danecreekphotography/electronics/README.md

# electronics
Random electronics projects
