danecreekphotography/electronics/LED controller board - Wemos/3D Models/Molex 22-05-3041 4-pin male horizontal.step

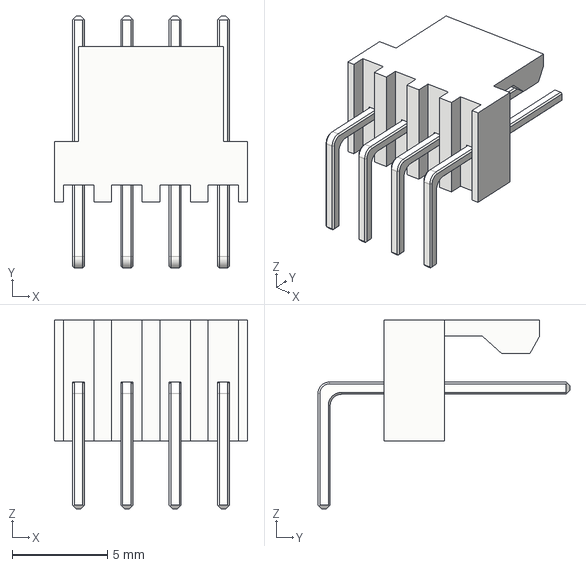
[picture p2: CAD file, 2020-07-19]
LED controller board - Wemos/3D Models/Molex 22-05-3041 4-pin male horizontal.step
10.2 x 13.2 x 9.93 mm
