danecreekphotography/electronics/LED controller board - Wemos/3D Models/22053021.stp

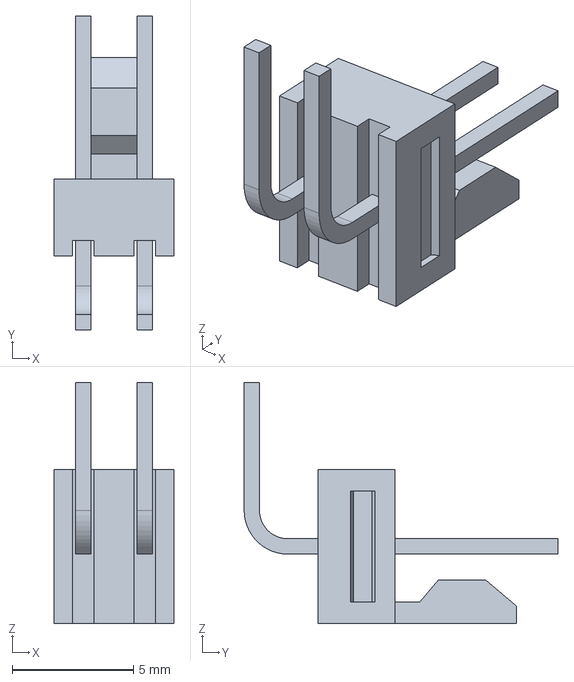
[picture p3: CAD file, 2020-07-19]
LED controller board - Wemos/3D Models/22053021.stp
4.93 x 12.9 x 9.93 mm
