danecreekphotography/electronics/LED controller board - Wemos/schematic.pdf

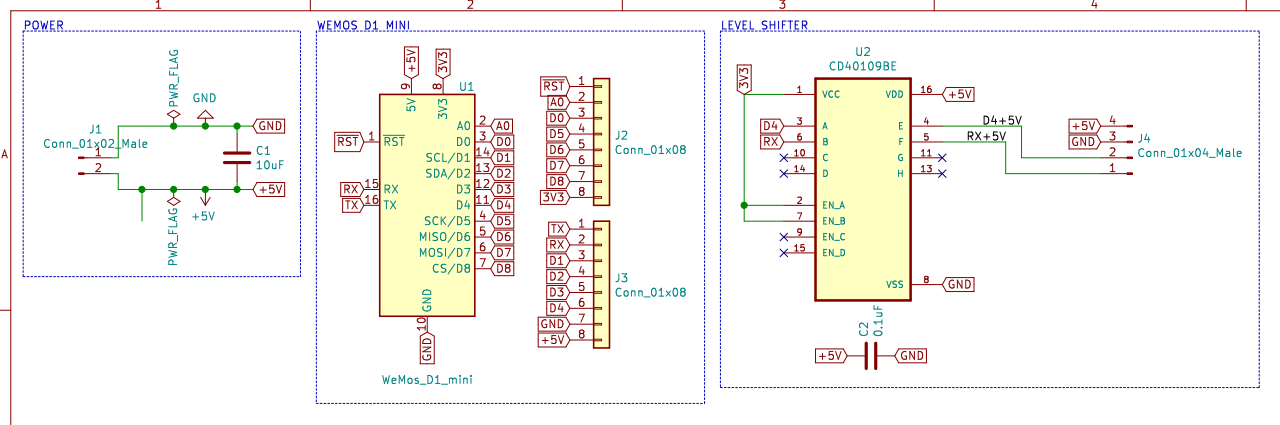
[picture p4: page 1]
