danecreekphotography/electronics/LED controller board - Wemos/LED controller board - Wemos.kicad_pcb

## KiCad design LED controller board - Wemos/LED controller board - Wemos.kicad_pcb (2020-07-19)

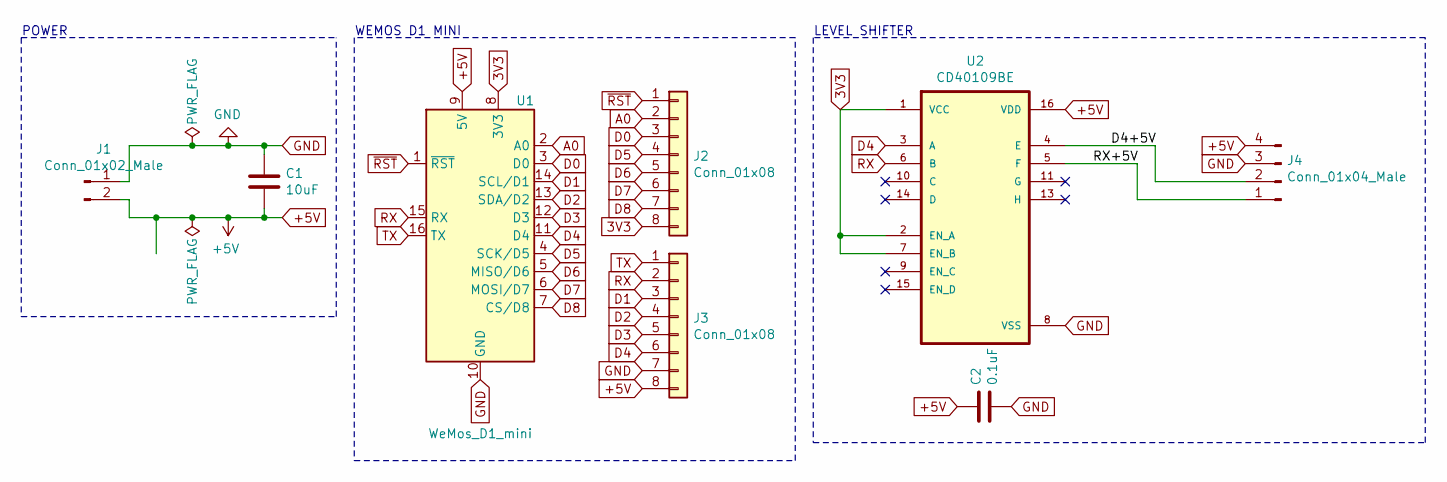
[picture p5: schematic LED controller board - Wemos.sch]

Parts:
C1: 10uF; C_Disc_D5.0mm_W2.5mm_P2.50mm
C2: 0.1uF; C_Disc_D5.0mm_W2.5mm_P5.00mm
J1: Conn_01x02_Male; Molex_KK-254_AE-6410-02A_1x02_P2.54mm_Horizontal
J2, J3: Conn_01x08; PinHeader_1x08_P2.54mm_Vertical
J4: Conn_01x04_Male; Molex_KK-254_AE-6410-04A_1x04_P2.54mm_Horizontal
U1: WeMos_D1_mini; WEMOS_D1_mini_light
U2: CD40109BE; 16TSSOP

Connections:
3V3: J2.8, U1.8 (3V3), U2.1 (VCC), U2.2 (EN_A), U2.7 (EN_B)
+5V: C1.2, C2.1, J1.2, J3.8, J4.4, U1.9 (5V), U2.16 (VDD)
/D4+5V: J4.2, U2.4 (E)
/RX+5V: J4.1, U2.5 (F)
A0: J2.2, U1.2 (A0)
D0: J2.3, U1.3 (D0)
D1: J3.3, U1.14 (SCL/D1)
D2: J3.4, U1.13 (SDA/D2)
D3: J3.5, U1.12 (D3)
D4: J3.6, U1.11 (D4), U2.3 (A)
D5: J2.4, U1.4 (SCK/D5)
D6: J2.5, U1.5 (MISO/D6)
D7: J2.6, U1.6 (MOSI/D7)
D8: J2.7, U1.7 (CS/D8)
GND: C1.1, C2.2, J1.1, J3.7, J4.3, U1.10 (GND), U2.8 (VSS)
RX: J3.2, U1.15 (RX), U2.6 (B)
TX: J3.1, U1.16 (TX)
~RST: J2.1, U1.1 (~RST)

Notes on the sheet:
POWER
WEMOS D1 MINI
LEVEL SHIFTER

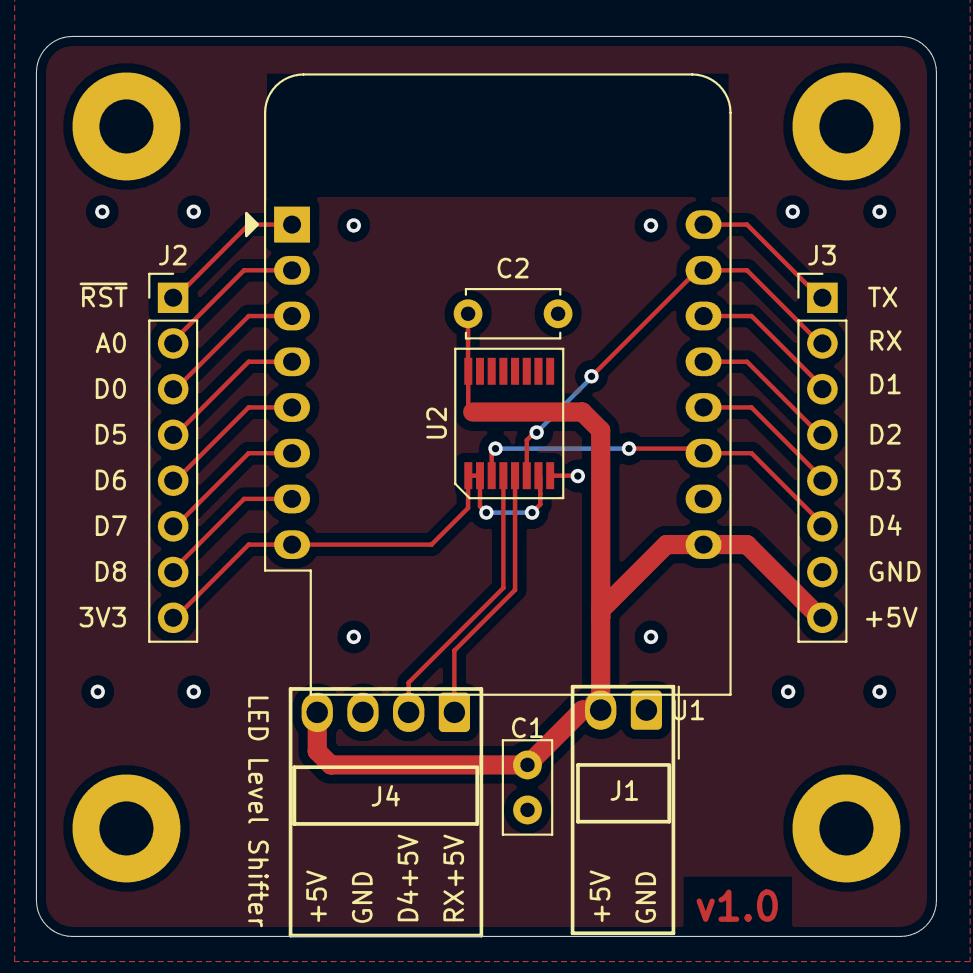
[picture p6: board LED controller board - Wemos.kicad_pcb from above]

Board: 2 copper layers, 50.0 x 50.0 mm, 8 parts (0 on the bottom side), 18 nets.
