danecreekphotography/electronics/(commit log)

2020-07-19 LED controller board - Wemos
    [22053021.stp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]
2020-07-19 Readme and schematics
2020-07-19 Update readme with PCBWay link
