danecreekphotography/electronics/(notices)

Notices in the files:
LED controller board - Wemos/LED controller board - Wemos.sch:
Licensed: MIT License
